omarkeshk/medical-payload-pod-thermal/(commit log)

2026-06-16 Medical payload pod thermal management — firmware, logging toolkit, CFD pipeline, experimental data
    [heat_cooling.csv, heat_fan_at_35.csv, heat_fan_off.csv]
2026-06-16 Slides: align transient bullets with figure panels (heating left, cooling right)
